Tsquash/particle/UI/blocked.png

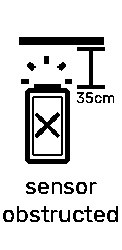
UI/blocked.png
