Tsquash/particle/2D/Acrylic.dxf

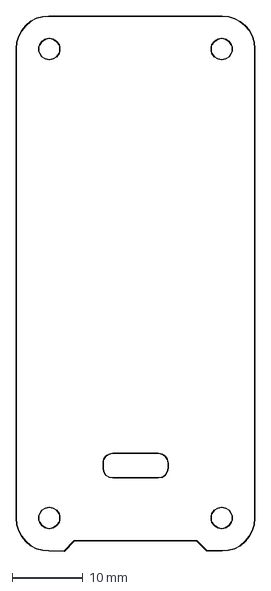
[picture p2: CAD file, 2026-10-28]
2D/Acrylic.dxf
33.8 x 75.8 mm
