Tsquash/particle/KICAD/symbols/button.STEP

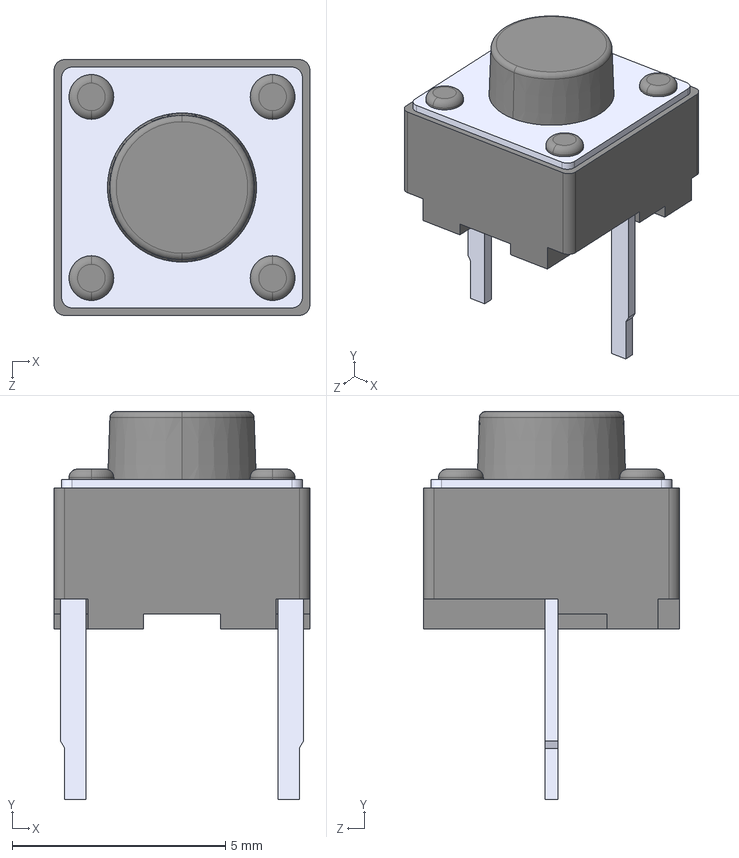
[picture p4: CAD file, 2026-10-28]
KICAD/symbols/button.STEP
6.00 x 9.10 x 6.00 mm
