Tsquash/particle/3D/BMV080.step

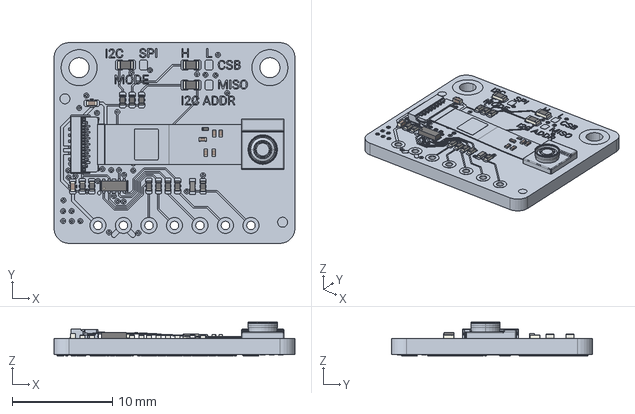
[picture p5: CAD file, 2026-10-28]
3D/BMV080.step
24.0 x 20.0 x 3.35 mm
