Tsquash/particle/3D/Shell.step

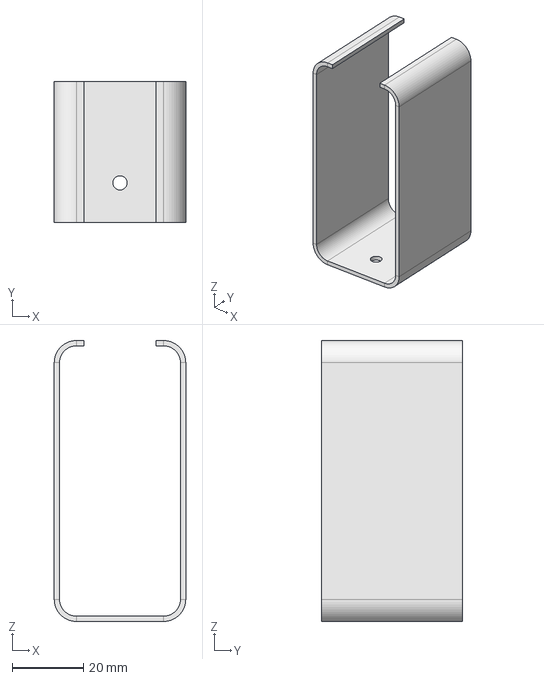
[picture p6: CAD file, 2026-10-28]
3D/Shell.step
37.0 x 39.5 x 79.0 mm
