Tsquash/particle/3D/SkeletonV1.1.3mf

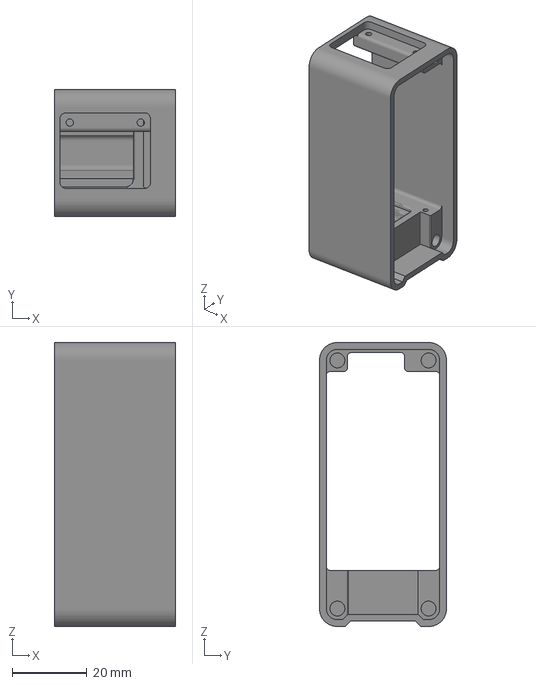
[picture p7: CAD file, 2026-10-28]
3D/SkeletonV1.1.3mf
32.5 x 34.0 x 76.0 mm
