Tsquash/particle/3D/ShellV2.3mf

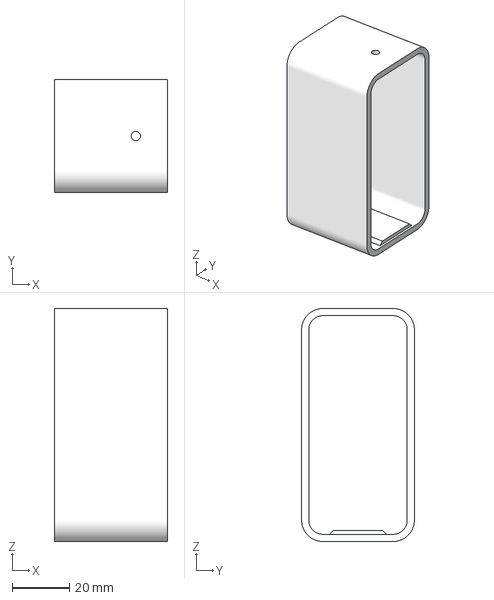
[picture p9: CAD file, 2026-10-28]
3D/ShellV2.3mf
39.5 x 39.4 x 81.4 mm
