Tsquash/particle/KICAD/particle.kicad_pcb

## KiCad design KICAD/particle.kicad_pcb (2026-10-28)

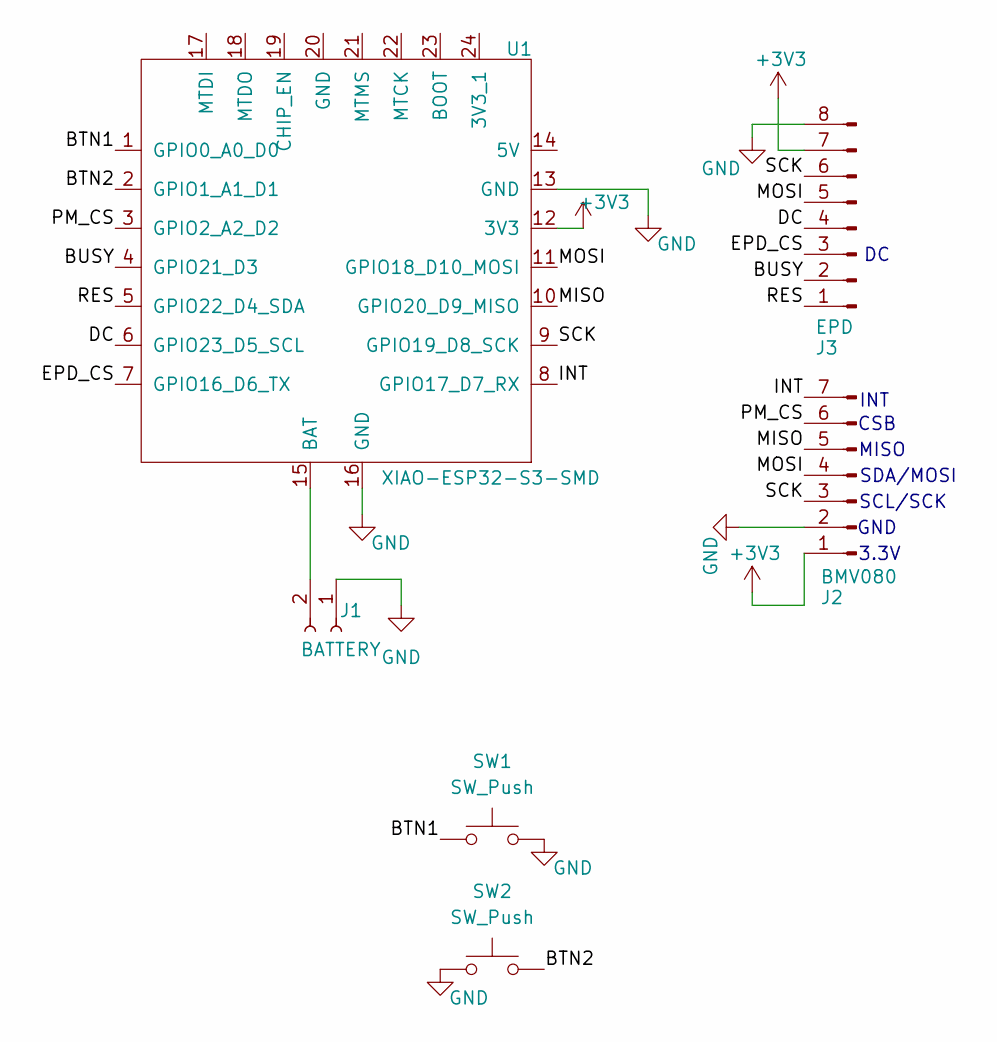
[picture p10: schematic particle.kicad_sch]

Parts:
J1: BATTERY; PinHeader_1x02_P2.54mm_Vertical
J2: BMV080; PinHeader_1x07_P2.54mm_Vertical
J3: EPD; PinHeader_2x04_P2.54mm_Vertical
SW1, SW2: SW_Push; SW_BUTT-2
U1: XIAO-ESP32-S3-SMD; XIAO-ESP32C6-SMD

Connections:
+3V3: J2.1, J3.7, U1.12 (3V3)
/BTN1: SW1.1, U1.1 (GPIO0_A0_D0)
/BTN2: SW2.2, U1.2 (GPIO1_A1_D1)
/BUSY: J3.2, U1.4 (GPIO21_D3)
/DC: J3.4, U1.6 (GPIO23_D5_SCL)
/EPD_CS: J3.3, U1.7 (GPIO16_D6_TX)
/INT: J2.7, U1.8 (GPIO17_D7_RX)
/MISO: J2.5, U1.10 (GPIO20_D9_MISO)
/MOSI: J2.4, J3.5, U1.11 (GPIO18_D10_MOSI)
/PM_CS: J2.6, U1.3 (GPIO2_A2_D2)
/RES: J3.1, U1.5 (GPIO22_D4_SDA)
/SCK: J2.3, J3.6, U1.9 (GPIO19_D8_SCK)
GND: J1.1, J2.2, J3.8, SW1.2, SW2.1, U1.13 (GND), U1.16 (GND)
unnamed: J1.2, U1.15 (BAT)

Notes on the sheet:
MISO
SDA/MOSI
3.3V
SCL/SCK
INT
CSB
GND

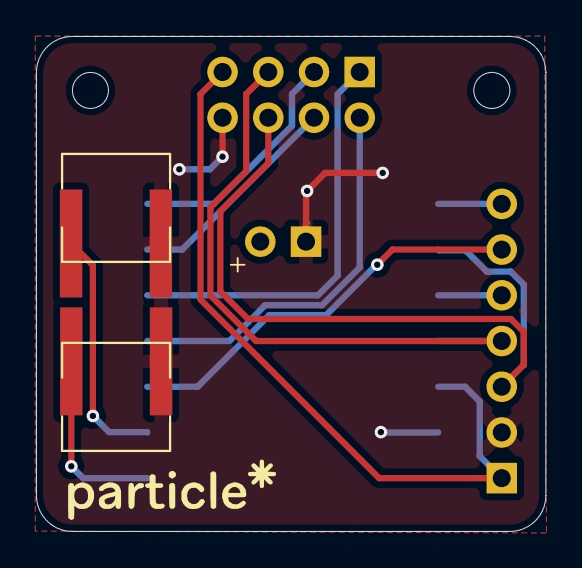
[picture p11: board particle.kicad_pcb from above]

Board: 2 copper layers, 28.3 x 27.5 mm, 6 parts (1 on the bottom side), 14 nets.
