Tsquash/particle/(commit log)

2026-10-28 added pairing graphics, 30 minute full refresh, changed BMV080 SPI clock, and reduced sensor polling
2026-10-28 added 2d/3d/gui/pcb files, and added a readme
2026-10-28 Remove KiCad local backups
    Ignore KiCad backup archives, autosaves, project-local settings, and generated footprint cache.
2026-10-28 Clarified button functionality and boot time in README
    Added note about device initialization time and updated button actions.
